wozeparrot/MushyCloud/images/pcb1.jpg

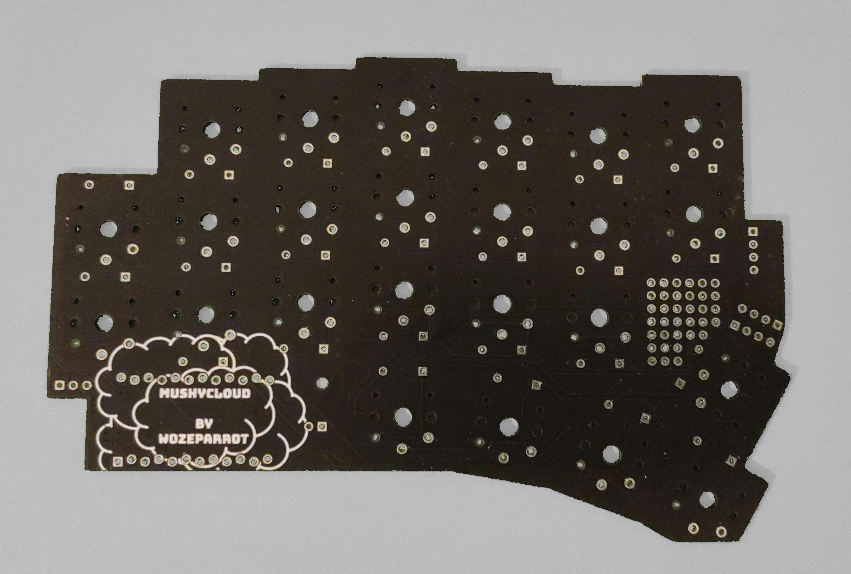
images/pcb1.jpg
