wozeparrot/MushyCloud/images/render0.png

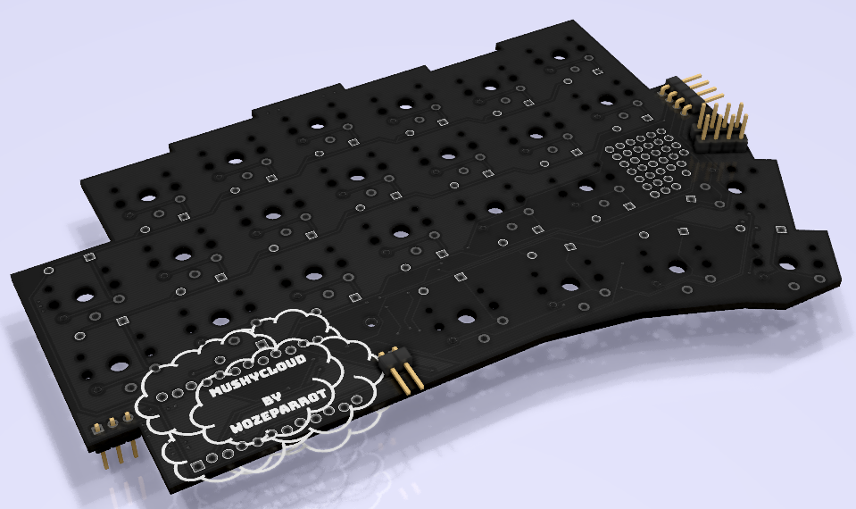
images/render0.png
