wozeparrot/MushyCloud/pcb/MushyCloud.sch

## KiCad design pcb/MushyCloud.sch (2021-04-14)

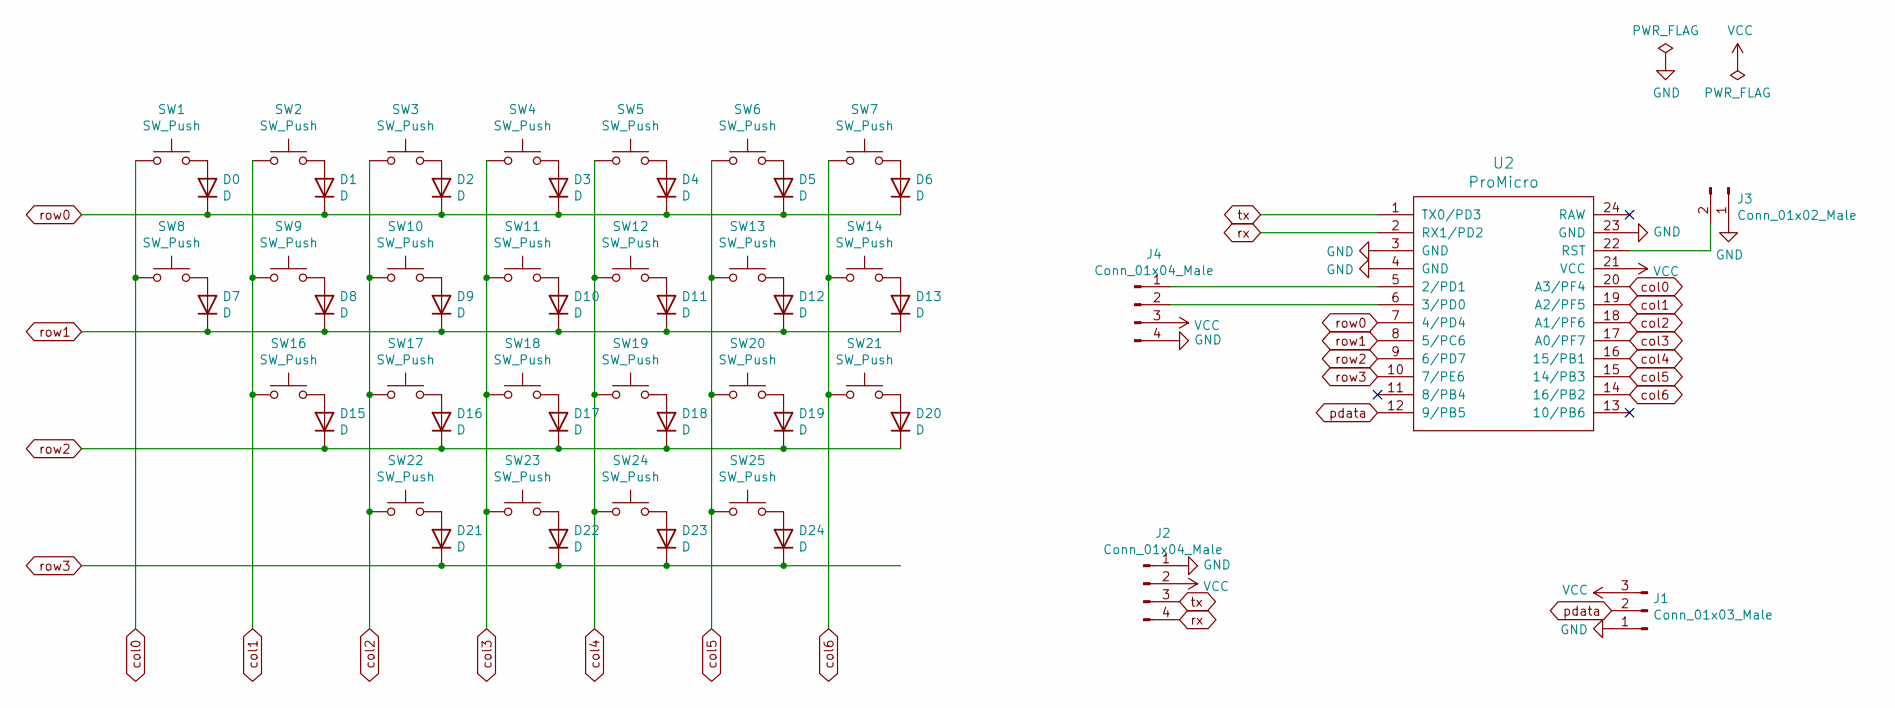
[picture p4: schematic MushyCloud.sch]

Parts:
D0, D1, D2, D3, D4, D5, D6, D7, D8, D9, D10, D11, D12, D13, D15, D16, D17, D18, D19, D20, D21, D22, D23, D24: D; Diode
J1: Conn_01x03_Male; PinHeader_1x03_P2.54mm_Vertical
J2: Conn_01x04_Male; PinHeader_1x04_P2.54mm_Horizontal
J3: Conn_01x02_Male; PinHeader_1x02_P2.54mm_Horizontal
J4: Conn_01x04_Male; PinHeader_1x04_P2.54mm_Vertical
SW1, SW2, SW3, SW4, SW5, SW6, SW7, SW8, SW9, SW10, SW11, SW12, SW13, SW14, SW16, SW17, SW18, SW19, SW20, SW21, SW22, SW23, SW24, SW25: SW_Push; Kailh-PG1350-1u-reversible-No-Clickhole-NoLED
U2: ProMicro; ArduinoProMicro-ZigZag-NoSilk

Connections:
GND: J1.1, J2.1, J3.1, J4.4, U2.3 (GND), U2.4 (GND), U2.23 (GND)
unnamed: D0.2 (A), SW1.2
unnamed: D1.2 (A), SW2.2
unnamed: D2.2 (A), SW3.2
unnamed: D3.2 (A), SW4.2
unnamed: D4.2 (A), SW5.2
unnamed: D5.2 (A), SW6.2
unnamed: D6.2 (A), SW7.2
unnamed: D7.2 (A), SW8.2
unnamed: D8.2 (A), SW9.2
unnamed: D9.2 (A), SW10.2
unnamed: D10.2 (A), SW11.2
unnamed: D11.2 (A), SW12.2
unnamed: D12.2 (A), SW13.2
unnamed: D13.2 (A), SW14.2
unnamed: D15.2 (A), SW16.2
unnamed: D16.2 (A), SW17.2
unnamed: D17.2 (A), SW18.2
unnamed: D18.2 (A), SW19.2
unnamed: D19.2 (A), SW20.2
unnamed: D20.2 (A), SW21.2
unnamed: D21.2 (A), SW22.2
unnamed: D22.2 (A), SW23.2
unnamed: D23.2 (A), SW24.2
unnamed: D24.2 (A), SW25.2
unnamed: J3.2, U2.22 (RST)
unnamed: J4.1, U2.5 (2/PD1)
unnamed: J4.2, U2.6 (3/PD0)
VCC: J1.3, J2.2, J4.3, U2.21 (VCC)
col0: SW1.1, SW8.1, U2.20 (A3/PF4)
col1: SW2.1, SW9.1, SW16.1, U2.19 (A2/PF5)
col2: SW3.1, SW10.1, SW17.1, SW22.1, U2.18 (A1/PF6)
col3: SW4.1, SW11.1, SW18.1, SW23.1, U2.17 (A0/PF7)
col4: SW5.1, SW12.1, SW19.1, SW24.1, U2.16 (15/PB1)
col5: SW6.1, SW13.1, SW20.1, SW25.1, U2.15 (14/PB3)
col6: SW7.1, SW14.1, SW21.1, U2.14 (16/PB2)
pdata: J1.2, U2.12 (9/PB5)
row0: D0.1 (K), D1.1 (K), D2.1 (K), D3.1 (K), D4.1 (K), D5.1 (K), D6.1 (K), U2.7 (4/PD4)
row1: D7.1 (K), D8.1 (K), D9.1 (K), D10.1 (K), D11.1 (K), D12.1 (K), D13.1 (K), U2.8 (5/PC6)
row2: D15.1 (K), D16.1 (K), D17.1 (K), D18.1 (K), D19.1 (K), D20.1 (K), U2.9 (6/PD7)
row3: D21.1 (K), D22.1 (K), D23.1 (K), D24.1 (K), U2.10 (7/PE6)
rx: J2.4, U2.2 (RX1/PD2)
tx: J2.3, U2.1 (TX0/PD3)
